vinayak-gupta0/external-pacing-4967/NSGA-II.png

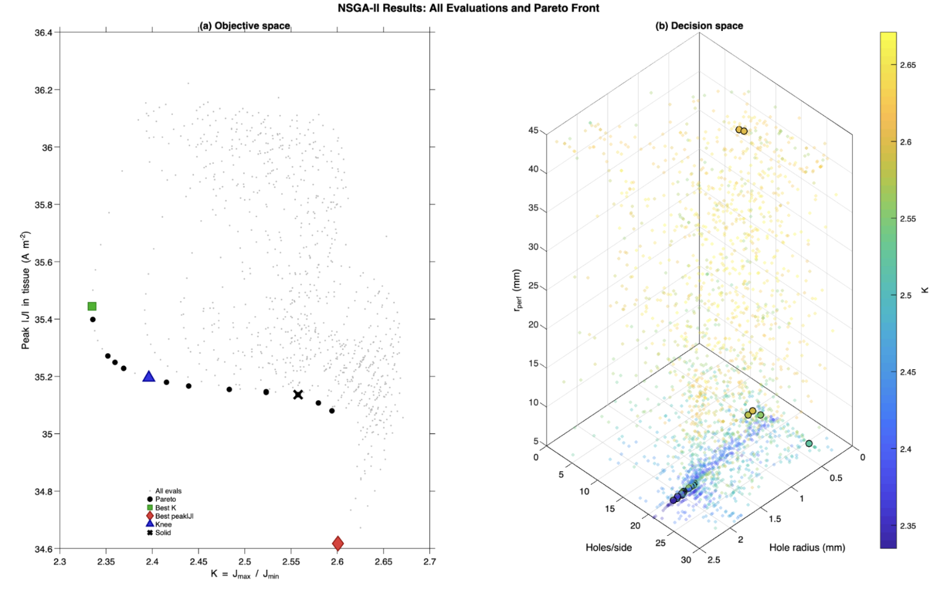
NSGA-II.png
