vinayak-gupta0/external-pacing-4967/Pacing_pad_design_exploded_view.3mf

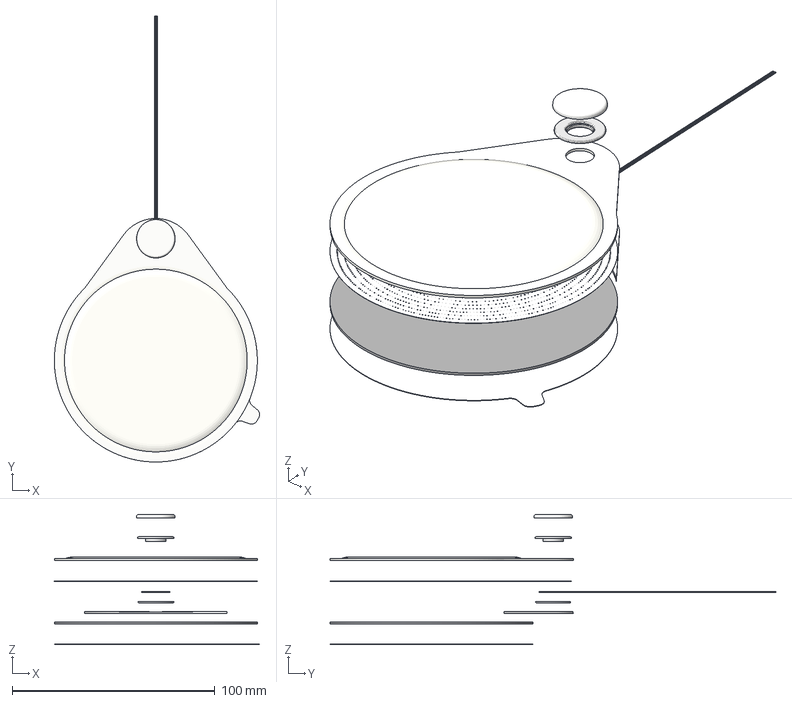
[picture p14: CAD file, 2026-05-26]
Pacing_pad_design_exploded_view.3mf
101.1 x 219.7 x 64.1 mm
Backing
Bottom insulating plate
Circular wire connector
Eyelet
Hydrogel
Perforated layer
Release Liner
Top insulating plate
Washer
Wire
