vinayak-gupta0/external-pacing-4967/Pacing_pad_design.3mf

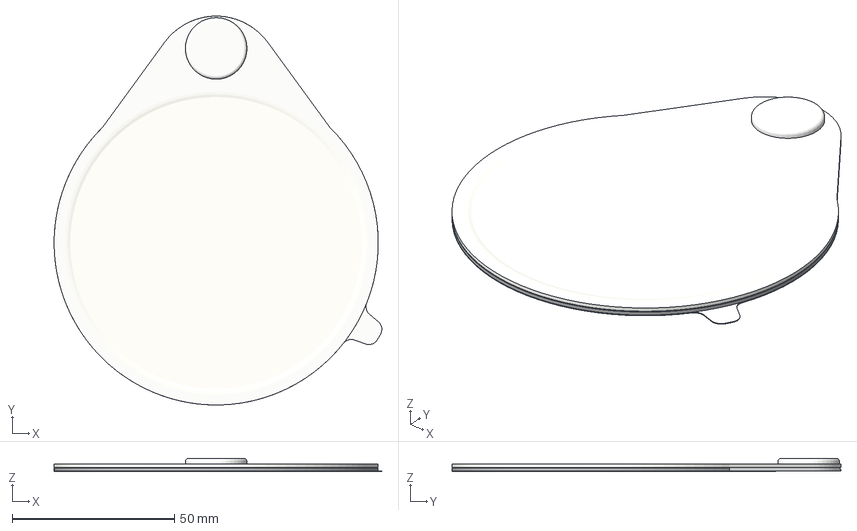
[picture p15: CAD file, 2026-05-25]
Pacing_pad_design.3mf
101.1 x 120.0 x 4.12 mm
Backing
Bottom insulating plate
Circular wire connector
Eyelet
Hydrogel
Perforated layer
Release Liner
Top insulating plate
Washer
