vinayak-gupta0/external-pacing-4967/(commit log)

2026-05-25 Rename Pacing pad design.3mf to Pacing_pad_design.3mf
    [Pacing pad design.3mf, Pacing_pad_design.3mf]
2026-05-29 Update index.html
    Removed heatmap
